elliott-turner/bevo-madness/main/motion.h

#define SPEED_NORMAL 15
#define SPEED_SLOW 10

#define SENSOR_RANGE 2500.0
#define WHITE_VAL 750.0
#define BLACK_VAL 2000.0

#define MOTOR_GAIN_P 0.020
#define MOTOR_GAIN_I 0.008
#define MOTOR_GAIN_D 0.002

#define LINE_GAIN_P 8
#define LINE_GAIN_I 0.001
#define LINE_GAIN_D 0

void move_straight(float dist);
void move_turn(float deg);
void move_stop(void);
bool check_for_line(void);
void move_to_line(void);
void follow_line_to_intersection(float dist);
