elliott-turner/bevo-madness/main/shooter.h

#define ENA 38 // P2.4
#define ENB 32 // P3.5
#define IN1 17 // P5.7
#define IN2 43 // P8.4
#define IN3 60 // P8.3
#define IN4 44 // P8.2

#define EN1B 24 // P4.0
#define EN2A 59 // P9.1
#define EN2B 63 // P6.3

#define IR 42 // P9.5

void shooter_start();
void shoot(int power);
void load();
