elliott-turner/bevo-madness/main/turret.ino

float current_angle = 0.0;
bool direction = true;
int steps = 0;

void turret_start() {
    pinMode(N1, OUTPUT);
    pinMode(N2, OUTPUT);
    pinMode(N3, OUTPUT);
    pinMode(N4, OUTPUT);
}

float turret_get_angle() {
    return current_angle;
}

void set_coils(int in1, int in2, int in3, int in4) {
    
    digitalWrite(N1, in1);
    digitalWrite(N2, in2);
    digitalWrite(N3, in3);
    digitalWrite(N4, in4);
}

void disable() {
    set_coils(0, 0, 0, 0);
}

void turret_set_angle(float angle) {
    float angle_delta = angle - current_angle;
    direction = angle_delta > 0;
    int num_steps = (int)(abs(angle_delta)*NG/NP*STEPS_PER_DEG);
    int delay = DELAY_MAX;
    int i;
    for (i=0; i<num_steps; i++) {
        switch (steps) {
            case 0: set_coils(1, 1, 0, 0); break;
            case 1: set_coils(0, 1, 0, 0); break;
            case 2: set_coils(0, 1, 1, 0); break;
            case 3: set_coils(0, 0, 1, 0); break;
            case 4: set_coils(0, 0, 1, 1); break;
            case 5: set_coils(0, 0, 0, 1); break;
            case 6: set_coils(1, 0, 0, 1); break;
            case 7: set_coils(1, 0, 0, 0); break;
            default: set_coils(0, 0, 0, 0); break;
        }
        if (direction) { steps++; }
        else { steps--; }
        if (steps > 7) { steps = 0; }
        if (steps < 0) { steps = 7; }
        if (i < num_steps/2) {
            if (delay > DELAY_MIN) { delay--; }
        }
        else {
            if (num_steps - i < DELAY_MAX - DELAY_MIN) { delay++; }
        }
        delayMicroseconds(delay);
    }
    current_angle = angle;
    disable();
}

void turret_move_angle(float angle) {
    turret_set_angle(current_angle + angle);
    disable();
}
