elliott-turner/bevo-madness/(commit log)

2022-03-25 Update arduino serial port for vscode
2022-04-26 add ultrasonic code
2022-04-26 add ir sensor code
2022-04-29 fix set coil function (remove broken macro calls)
    [turret.ino]
2022-05-03 prevent stepper overheat
2022-05-03 fix wiring issue
2022-05-03 use encoder values to make movements more accurate
2022-05-04 finish pid function
2022-05-04 add pid control to motion functions
2022-05-04 add PID line following
2022-05-05 Fixed ratio for distance to encoder steps.
    [motion.ino]
2022-05-05 handle case where bot starts on center line
2022-05-05 revert to old (more reliable) move to line script
    [main.ino]
2022-05-05 fix issue with back or front straightening measurement being off the line
    [motion.ino]
2022-05-05 check and fix distance from baskets and add debug serial prints
    [main.ino]
2022-05-17 add picture and schematic to readme
